pbrook/pullometer/hardware/pullometer.kicad_pcb

## KiCad design hardware/pullometer.kicad_pcb (2016-03-31)

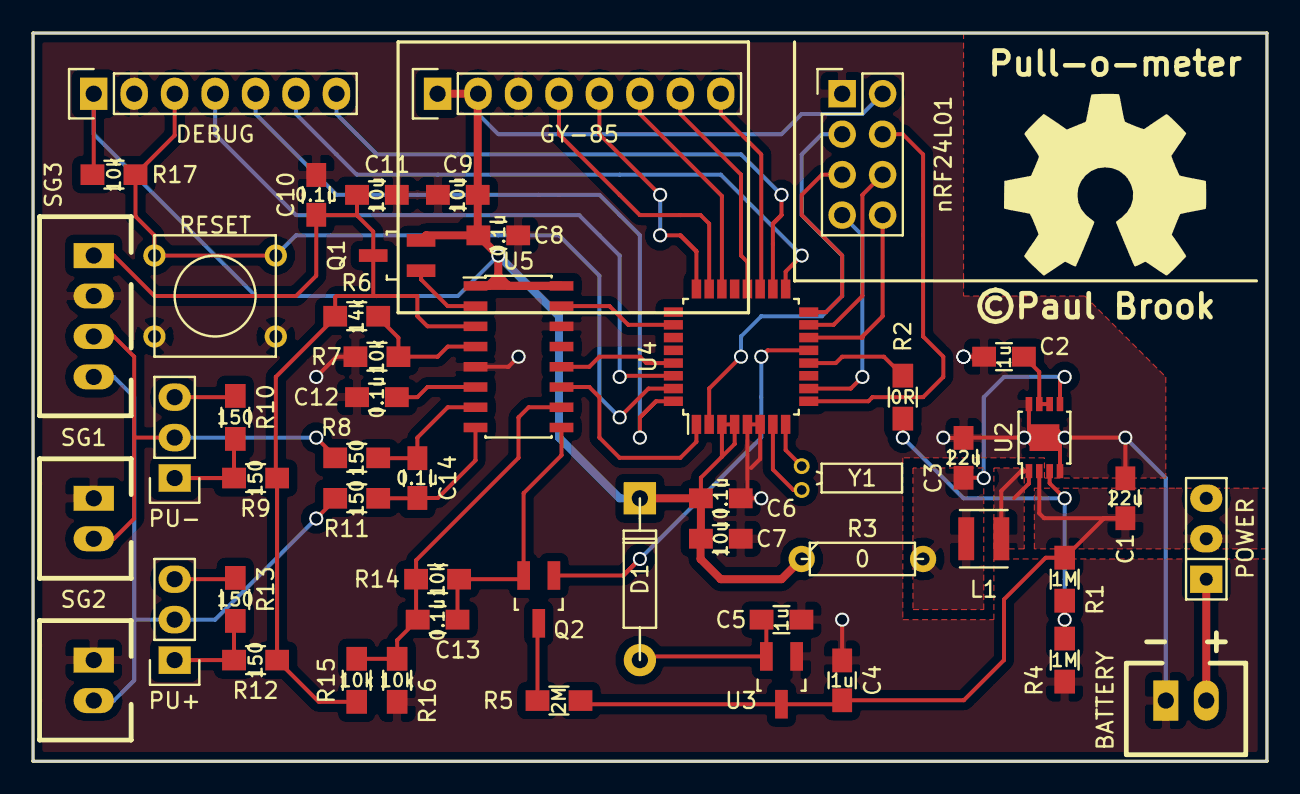
[picture p1: board pullometer.kicad_pcb from above]

Board: 2 copper layers, 77.5 x 45.7 mm, 51 parts (0 on the bottom side), 47 nets.

Parts:
C1, C3: 22u; C_0805_HandSoldering_V
C2, C4, C5: 1u; C_0805_HandSoldering_V
C6, C8, C10, C12, C13, C14: 0.1u; C_0805_HandSoldering_V
C7, C9, C11: 10u; C_0805_HandSoldering_V
D1: 1n4001; DO-41
JP1: PU-; Pin_Header_Straight_1x03
JP2: PU+; Pin_Header_Straight_1x03
L1: 4.7uH; Neosid_Inductor_SMS-ME3015
P1: BATTERY; JST-XH-2
P2: SG1; JST-XH-2
P3: SG2; JST-XH-2
P4: DEBUG; Pin_Header_Straight_1x07
P5: SG3; JST-XH-4
Q1: MMBT4403; SOT-23_Handsoldering
Q2: TMS2302CX; SOT-23_Handsoldering
R1, R4: 1M; R_0805_HandSoldering_V
R2: 0R; R_0805_HandSoldering_V
R3: 0; R3-LARGE_PADS
R5: 2M; R_0805_HandSoldering_V
R6: 14k; R_0805_HandSoldering_V
R7, R14, R15, R16, R17: 10k; R_0805_HandSoldering_V
R8, R9, R10, R11, R12, R13: 150; R_0805_HandSoldering_V
SW1: RESET; SW_PUSH_SMALL
SW2: POWER; SW_Micro_SPST
U1: nRF24L01; Pin_Header_Straight_2x04
U2: LTC3621; MSOP-8-1EP_3x3mm_Pitch0.65mm
U3: MCP1702; SOT-23_Handsoldering
U4: MKL05Z32VLC4; LQFP-32_7x7mm_Pitch0.8mm
U5: HX711; SOIC-16_3.9x9.9mm_Pitch1.27mm
U6: GY-85; Socket_Strip_Straight_1x08
Y1: 32.768kHz; Crystal_Round_Horizontal_2mm

Connections:
+3V3: C6.1, C7.1, C8.1, C9.1, D1.1, P4.1, Q1.2, R3.1, R17.1, U1.2, U4.3, U4.4, U5.1, U5.16, U6.1, U6.2
/BAT_EN: Q2.1, U4.13
/E+: C10.1, C11.1, P5.1, Q1.3, R6.1, R9.2, R12.2, R15.2, U5.3
/HX_DATA: U4.29, U5.12
/HX_RATE: U4.26, U5.15
/HX_SCK: U4.1, U5.11
/IN+: JP2.2, P3.2, P5.4, R11.2
/IN-: JP1.2, P2.2, P5.3, R8.2
/INT_A: U4.20, U6.7
/INT_G: U4.19, U6.8
/INT_M: U4.22, U6.6
/MISO: U1.7, U4.10
/MOSI: U1.6, U4.15
/RF_CE: U1.3, U4.2
/RF_CS: U1.4, U4.9
/RF_IRQ: U1.8, U4.14
/RUN: R1.2, R2.2, R4.1, U2.3
/SCK: U1.5, U4.16
/SCL: U4.23, U6.4
/SDA: U4.24, U6.5
/SW: L1.2, U2.1
/SWD_CLK: P4.4, U4.30
/SWD_DIO: P4.5, U4.32
/SWD_RESET: P4.3, R17.2, SW1.1, U4.31
/S_RUN: R2.1, U4.12
/UART_RX: P4.6, U4.17
/UART_TX: P4.7, U4.18
/Vbat: C1.1, C4.1, R1.1, R5.1, SW2.2, U2.2, U3.3
/Vbuck: C3.1, L1.1, R3.2, U2.5
GND: C1.2, C2.2, C3.2, C4.2, C5.2, C6.2, C7.2, C8.2, C9.2, C10.2, C11.2, C12.2, P1.1, P2.1, P3.1, P4.2, P5.2, R4.2, R7.2, R16.2, SW1.2, U1.1, U2.4, U2.8, U2.9, U3.1, U4.5, U4.6, U5.5, U5.14, U6.3
unnamed: C2.1, U2.6, U2.7
unnamed: C5.1, D1.2, U3.2
unnamed: C12.1, U5.6
unnamed: C13.1, Q2.2, R14.1, U5.9
unnamed: C13.2, R14.2, R15.1, R16.1, U5.10
unnamed: C14.1, R11.1, U5.8
unnamed: C14.2, R8.1, U5.7
unnamed: JP1.1, R9.1, R10.2
unnamed: JP1.3, R10.1
unnamed: JP2.1, R12.1, R13.2
unnamed: JP2.3, R13.1
unnamed: P1.2, SW2.1
unnamed: Q1.1, U5.2
unnamed: Q2.3, R5.2
unnamed: R6.2, R7.1, U5.4
unnamed: U4.7, Y1.2
unnamed: U4.8, Y1.1
