pbrook/pullometer/(commit log)

2016-03-07 initial hardware design
    [pullometer.kicad_pcb, pullometer.sch]
2016-03-31 Production hardware
    [pullometer.kicad_pcb, pullometer.sch]
2016-05-22 Initial Firmware
    Basic accelerometer test.
2016-05-26 Initial strain gauge and accelerometer code.
2016-06-13 Inertial tracking and basic calibration.
2016-06-19 Glitch filter on recalibration.
    [imu.cc]
2016-07-03 Initial power management code.
2016-07-07 Sleep mode power saving tweaks
