pbrook/pullometer/(notices)

Notices in the files:
hardware/pullometer.kicad_pcb:
©Paul Brook
